InstrumentalSMN/ESP8266_RTOS_SDK/workspace/NodeMcu-V21-CP2102-Lua-ESP8266-pinout-mischianti-high-resolution.png

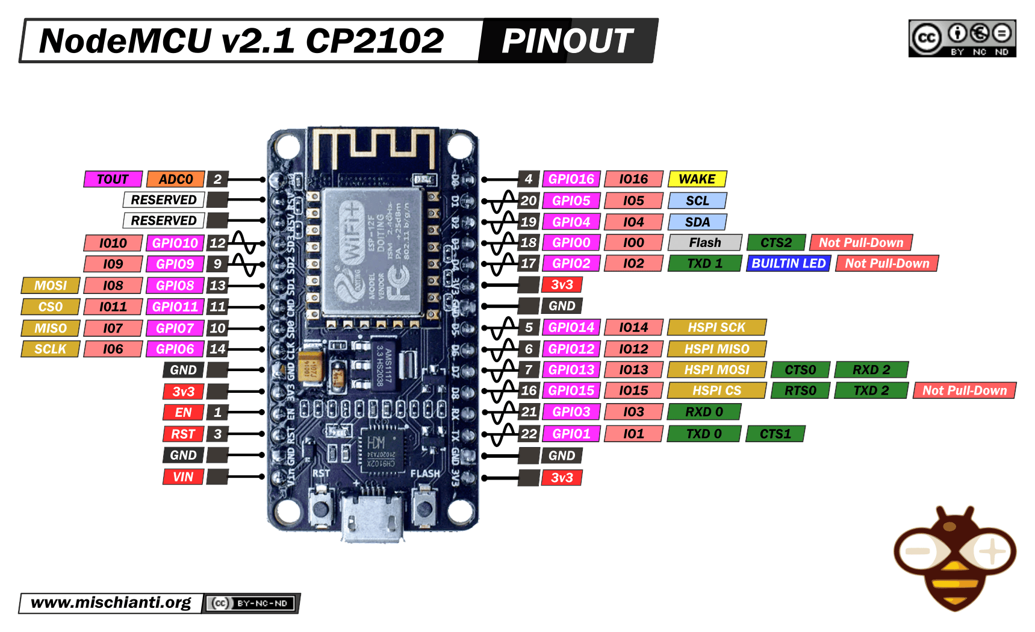
workspace/NodeMcu-V21-CP2102-Lua-ESP8266-pinout-mischianti-high-resolution.png
