InstrumentalSMN/ESP8266_RTOS_SDK/workspace/systemMonitorLab/hardware/Documentos/Planificación de Trabajo SMA_Lab.docx

Plan de trabajo

Sistema de monitoreo ambiente para el laboratorio de calibración (RIC III)

Autor: Cristian Aranda

Registro de cambios

Revisión | Cambios Realizados | Fecha
1.1 | Creación del documento | 09/06/2023
1.2
1.3

1. Descripción técnica y propósito del proyecto

La CLI cuenta con un laboratorio donde realiza calibraciones en las variables temperatura, humedad y presión. Las condiciones ambientes del laboratorio son de interés a la hora de realizar cualquier experimento, por ejemplo, para medir la presión, es preciso que la temperatura se mantenga constante y que la humedad este por debajo del 80%. El objetivo de este proyecto es diseñar una red de nodos, distribuidos en distintas posiciones del laboratorio, donde medirán las variables temperatura, humedad y presión. Cada nodo deberá medir el entorno cercano de cada equipamiento de calibración. El laboratorio cuenta con los siguientes equipos:

1. Cámara climática de temperatura y humedad. (Activa)
2. Baños térmicos para termómetros de vidrio y PT100 (Activa)
3. Bomba de presión, para barómetros aneroides (Activa)
4. Cámara barométrica de presión (En mantenimiento)

Para realizar dicho propósito se implementará un nodo con la placa NodeMCU ESP8266 que medirá la presión, temperatura y humedad ambiente de sensores a determinar. Dicho nodo realizará la transmisión de los datos dentro de la red LAN interna de la CLI, por Wifi, hacia un servidor WebSocket. Se desarrollará la aplicación Web y el servidor con el framework Django en python tal que se pueda acceder desde cualquier computadora a los datos de ambiente de cualquier nodo.

2. Alcance del proyecto

El proyecto incluye:

- El diseño de un adquisidor de datos con la capacidad de medir, procesar y transmitir los

datos.

- El diseño de una aplicación Web que permita visualizar los datos en tiempo real desde cualquier PC conectada a la Red LAN del laboratorio.

El proyecto no incluye los siguientes elementos:

- La guarda de datos en una base de datos
- La interacción con el sistema de calibración

3. Lista de materiales y supuestos del proyecto

A continuación se detalla los componentes e insumos necesarios para el proyecto.

Nombre del Producto | Proveedor/Empresa | Cantidad | Precio por unidad ( $ARS) | Total ( $ARS) | DataSheet | JUSTIFICACIÓN Y USO
Sensor de temperatura y humedad | Aht10 (https://articulo.mercadolibre.com.ar/MLA-1165029663-sensor-humedad-y-temperatura-alta-presicion-aht10-i2c-hobb-_JM) | 1 | 1621 | 1621 | dataSheet (https://server4.eca.ir/eshop/AHT10/Aosong_AHT10_en_draft_0c.pdf) | Opcion A
| Dht22 (https://www.todomicro.com.ar/arduino/225-sensor-de-humedad-y-temperatura-dht22-arduino.html) | 1 | 3268.8 | 3268.8 | dataSheet (https://www.sparkfun.com/datasheets/Sensors/Temperature/DHT22.pdf) | Opcion B
Sensor de Presion | BMP180 (https://www.hobbytronica.com.ar/MLA-916739423-modulo-sensor-presion-atmosferica-temperatura-bmp180-arduino-_JM) | 0 | 1115 | 0 | dataSheet (https://media.digikey.com/pdf/Data%20Sheets/Bosch/BMP180.pdf) | Opcion A
| BMP280 (https://www.todomicro.com.ar/arduino/350-modulo-sensor-de-presion-y-temperatura-bmp280.html) | 5 | 1007.76 | 5038.8 | dataSheet (https://www.digikey.com/en/products/detail/bosch-sensortec/BMP280/6136307) | Opcion B
Central | ESP8266 (https://www.todomicro.com.ar/arduino/223-nodemcu-wifi-esp8266.html) | 0 | 2360.54 | 0 | dataSheet (http://www.adafruit.com/datasheets/ESP8266_Specifications_English.pdf)
Fuente | PowerSupply (https://www.todomicro.com.ar/cargadores-y-baterias/666-fuente-de-alimentacion-5v-2a.html) | 0 | 2941.12 | 0 | -

Tabla de componentes para el proyecto

En la tabla anterior se detallan los sensores con su precio y proveedor y cantidad. Cabe aclarar que solo se comprará el par Opción A u Opción B.

4. Avance del proyecto

link de tareas en Click Up: https://sharing.clickup.com/30940872/l/h/xg7p8-6924/68c866c16f51e5f

Fecha 09/06/2023:

Tareas realizadas:

- Se estudió el funcionamiento de ESP8266 y su framework.
- Se buscó y evaluó tipos de sensores aptos y compatibles con el datalogger
- Se está estudiando
- Se configuró el ESP8266 para ser programado con Eclipse y el framework ESP8266 RTOS.
- Se creó un servidor TCP/IP en la red wifi de TIC y se logró la conexión del módulo ESP8266 para enviar datos de prueba al servidor

Tareas en proceso:

- Se está estudiando la programación con FREE RTOS
- Se está realizando programas de prueba para enviar mensajes al servidor de prueba NET CAT
- Se está estudiando la interfaz SPI/I2C de los sensores para conectar con el módulo ESP8266

Próximas tareas:

- Crear un servidor WEB socket con DJANGO channels.
- Comprar los sensores y realizar pruebas

4. Requerimientos

a) Requerimientos de Hardware

b) Requerimientos de Software

c) Requerimientos de medición

d) Requerimientos de comunicación

f) Requerimientos de funcionamiento

5. Entregables principales del proyecto

6. Desglose del trabajo en tareas

8. Gestión de riesgos

9. Gestión de la calidad

Av. Dorrego 4019 (C1425GBE) Buenos Aires, Argentina Tel: (+54 011) 5167-6767 - smn@smn.gob.ar

1983/2023 - 40 años de democracia |
