InstrumentalSMN/ESP8266_RTOS_SDK/workspace/systemMonitorLab/hardware/Documentos/Insumos SistemaDeMonitoreoAmbiente.xlsx

Articulo | Cantidad | Precio Unidad | Precio Total | Proveedor | Link | Observaciones
Conversor TTL-RS232 | 2 | $4317.00 | $8634.00 | CandyHo | https://candy-ho.com/producto/modulo-conector-max3232-rs232-serial-port-ttl-converter-db9/
Sensor BMP280 | 3 | $1931.00 | $5793.00 | CandyHo | https://candy-ho.com/producto/sensor-presion-atmosferica-arduino-bmp280-barometro-alta-pr/
Tiras de pines hembra Arduino | 4 | $759.00 | $3036.00 | CandyHo | https://candy-ho.com/producto/tiras-de-40-pines-hembra-paso-2-54mm-recta-1-fila-arduino/
Kit de cables Arduino | 1 | $7561.00 | $7561.00 | CandyHo | https://candy-ho.com/producto/kit-120-cables-20cm-protoboard-arduino-m-m-m-h-h-h-kit22/
Multímetro Digital | 3 | $31493.00 | $94479.00 | Electrocomponentes SA | https://www.electrocomponentes.com/tienda/instrumental-medicion/multimetros/portatiles/multimetro-digital-compacto-uni-t-ut33a-plus-tester
Conversor TTL-RS485 | 3 | $2260.00 | $6780.00 | Microelectronica | https://www.microelectronicash.com/arduino-485xttl--det--ARDUINO-485XTTL
LLAVE TECLA C/LUZ 10A 250V ON-OFF | 2 | $1087.94 | $2175.88 | Microelectronica | https://www.microelectronicash.com/lt-105--det--LT-105
FUENTE SWITCHING 5V 2.5A | 3 | $7280.27 | $21840.81 | Microelectronica | https://www.microelectronicash.com/fuente-sw5-2-5--det--FUENTE-SW5-2.5
ALICATE PUNTA FINA 1mm 130mm | 2 | $17151.75 | $34303.50 | Microelectronica | https://www.microelectronicash.com/xr-170ii--det--XR-170II (https://www.microelectronicash.com/fuente-sw5-2-5--det--FUENTE-SW5-2.5)
LUPA DE VIDRIO CON PIE Y SOPORTES | 2 | $11282.04 | $22564.08 | Microelectronica | https://www.microelectronicash.com/lupa-pie--det--LUPA-PIE (https://www.microelectronicash.com/stanley-84054--det--STANLEY-84054)
TIRA DE PINES LARGOS 2x40 P/IMPRESO | 6 | $1821.34 | $10928.04 | Microelectronica | https://www.microelectronicash.com/tpl2x40--det--TPL2X40
BORNERA DOBLE AZUL PARA IMPRESO 8A 300V | 3 | $250.61 | $751.83 | Microelectronica | https://www.microelectronicash.com/b2p--det--B2P (https://www.microelectronicash.com/xr-170ii--det--XR-170II)
BORNERA TRIPLE AZUL PARA IMPRESO 8A 300V | 3 | $290.08 | $870.24 | Microelectronica | https://www.microelectronicash.com/b3p--det--B3P (https://www.microelectronicash.com/lupa-pie--det--LUPA-PIE)
ALICATE P/ELECTRICIDAD 1000V | 2 | $15289.85 | $30579.70 | SyC | http://www.sycelectronica.com.ar/articulo.php?codigo=HT-917
MALLA DESOLDANTE 2.0MM | 2 | $1167.27 | $2334.54 | SyC | http://www.sycelectronica.com.ar/articulo.php?codigo=MALLADESOLD-2.0
Destornilladores Perilleros Largos Plano Philips Proskit 509 | 2 | $9700.00 | $19400.00 | TECNOCENTER | https://articulo.mercadolibre.com.ar/MLA-1164194081-destornilladores-perilleros-largos-plano-philips-proskit-509-_JM
Sensor DHT22 | 2 | $7434.00 | $14868.00 | TodoMicro | Sensor De Humedad Y Temperatura DHT22 (todomicro.com.ar) (https://www.todomicro.com.ar/arduino/225-sensor-de-humedad-y-temperatura-dht22-arduino.html)
NodeMCU ESP8266 | 2 | $5123.30 | $10246.60 | TodoMicro | Nodemcu Wifi Esp8266 (todomicro.com.ar) (https://www.todomicro.com.ar/arduino/223-nodemcu-wifi-esp8266.html)
 |  |  | $297146.22
 |  | Para comprar | $57211.48
SaldoClaudio | 50000
 |  |  | -$7211.48
 |  | Microelectronica | $100214.38
 |  |  | $0.00
 |  |  | $0.00
 |  |  | $0.00
TOTAL |  |  | $744506.82
Presupuesto |  |  | $18000000.00
Restante |  |  | $17255493.18
