InstrumentalSMN/ESP8266_RTOS_SDK/workspace/systemMonitorLab/hardware/3DCase/Sistema de monitoreo/Bottom Carcaza/Botton Carcaza.stl

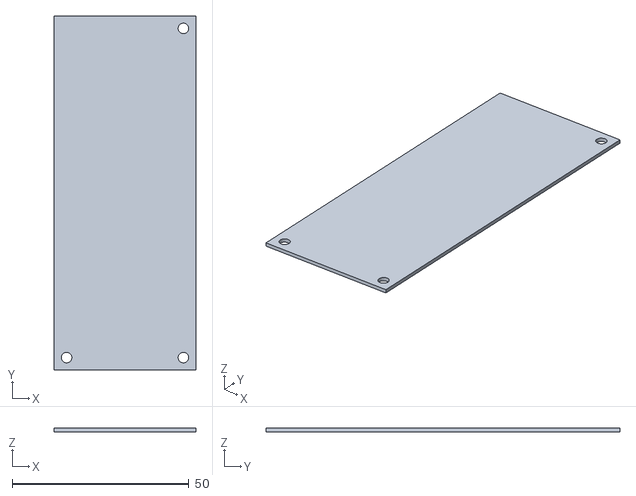
[picture p2: CAD file, 2025-02-17]
workspace/systemMonitorLab/hardware/3DCase/Sistema de monitoreo/Bottom Carcaza/Botton Carcaza.stl
40.0 x 100.0 x 1.00
