InstrumentalSMN/ESP8266_RTOS_SDK/workspace/systemMonitorLab/hardware/3DCase/Sistema de monitoreo/Top Carcaza/tinker.obj

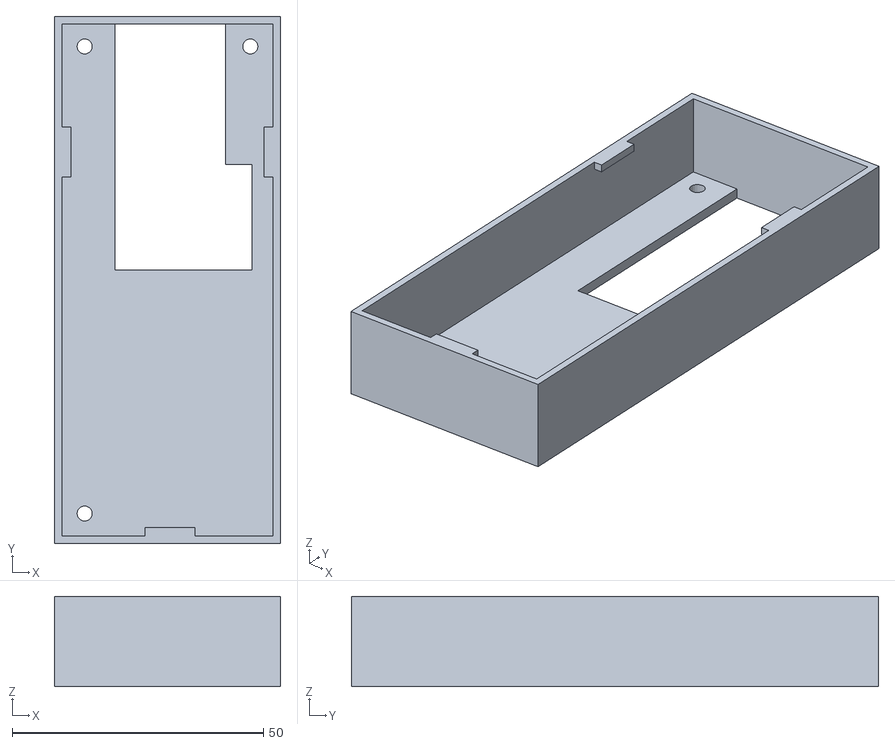
[picture p3: CAD file, 2025-02-17]
workspace/systemMonitorLab/hardware/3DCase/Sistema de monitoreo/Top Carcaza/tinker.obj
45.0 x 105.0 x 18.0
