InstrumentalSMN/ESP8266_RTOS_SDK/workspace/systemMonitorLab/hardware/NodoAmbienteSMN/recursos/bmp280_module.stp

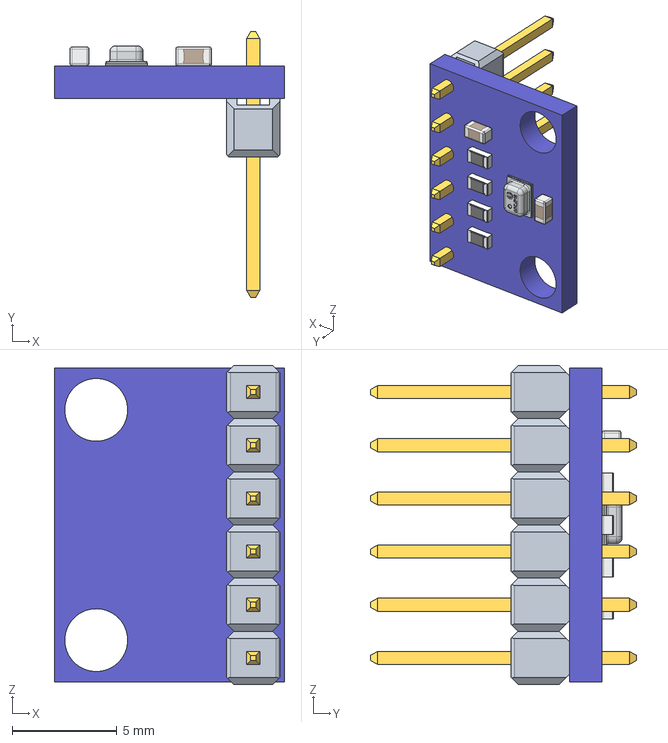
[picture p4: CAD file, 2025-02-21]
workspace/systemMonitorLab/hardware/NodoAmbienteSMN/recursos/bmp280_module.stp
11.0 x 12.7 x 15.2 mm
