InstrumentalSMN/ESP8266_RTOS_SDK/(list of files, cad)

Other CAD files:
workspace/systemMonitorLab/hardware/3DCase/Sistema de monitoreo/Bottom Carcaza/tinker.obj
workspace/systemMonitorLab/hardware/3DCase/Sistema de monitoreo/Top Carcaza/Top Carcaza.stl
workspace/systemMonitorLab/hardware/NodoAmbienteSMN/recursos/bmp280_module_Shrinkwrap.ipt
