InstrumentalSMN/ESP8266_RTOS_SDK/workspace/systemMonitorLab/hardware/NodoAmbienteSMN/NodoV2/pcb_build_resources/PCBsystem_page-0001.jpg

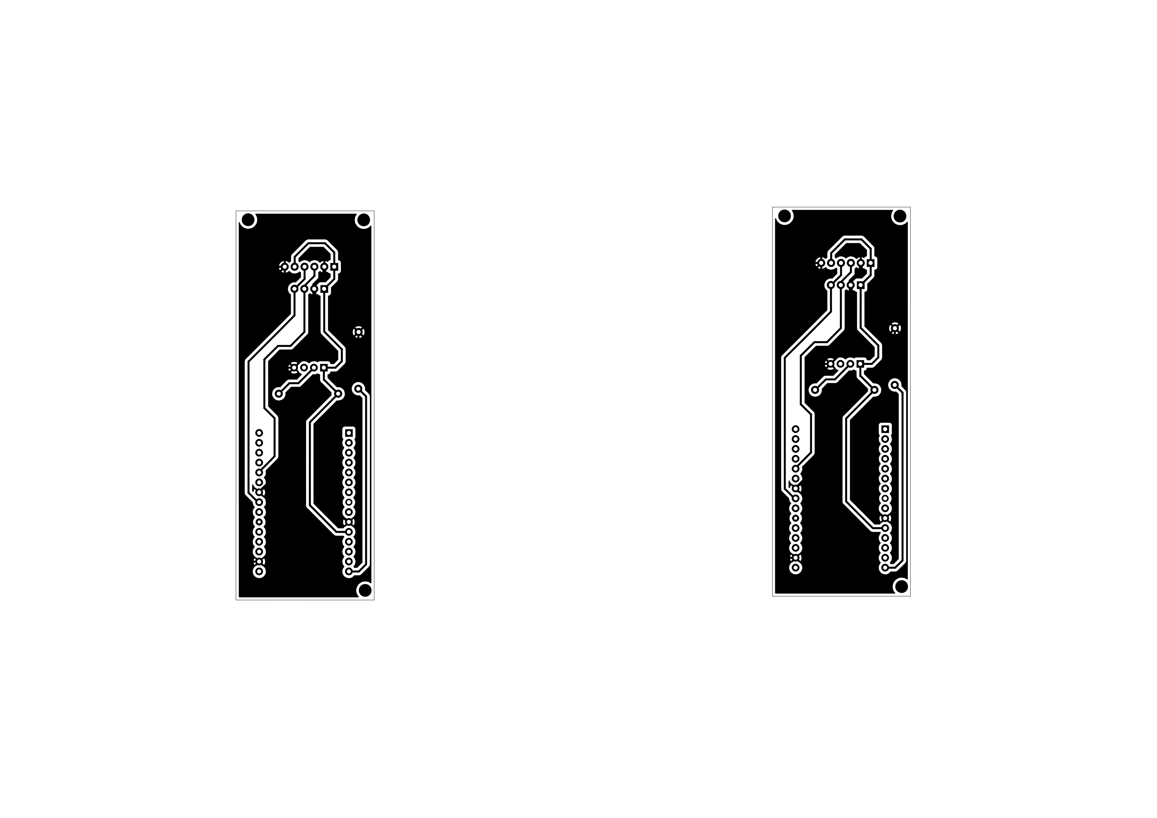
workspace/systemMonitorLab/hardware/NodoAmbienteSMN/NodoV2/pcb_build_resources/PCBsystem_page-0001.jpg
