InstrumentalSMN/ESP8266_RTOS_SDK/workspace/systemMonitorLab/hardware/Pruebas/aht10.png

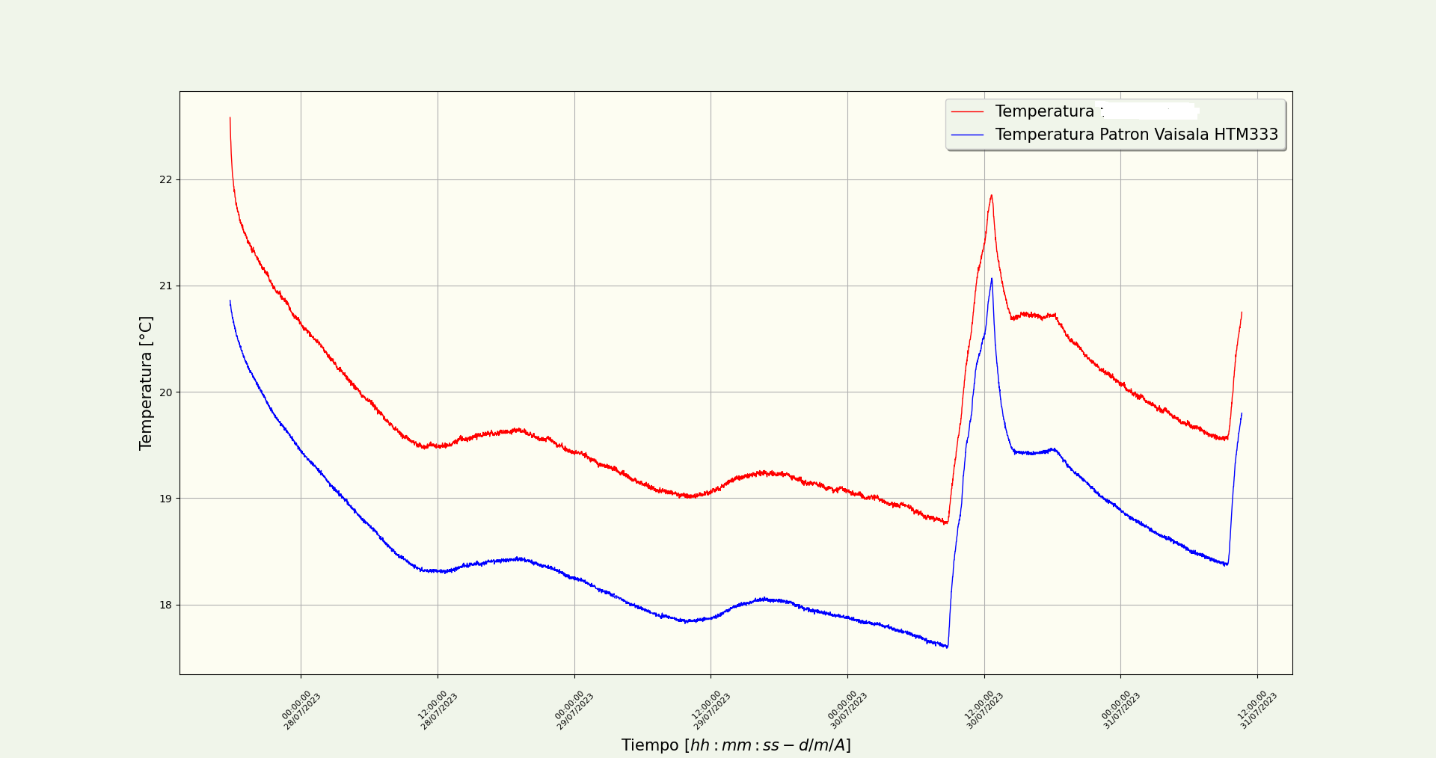
workspace/systemMonitorLab/hardware/Pruebas/aht10.png
