InstrumentalSMN/ESP8266_RTOS_SDK/workspace/systemMonitorLab/hardware/Pruebas/aht10_rh.png

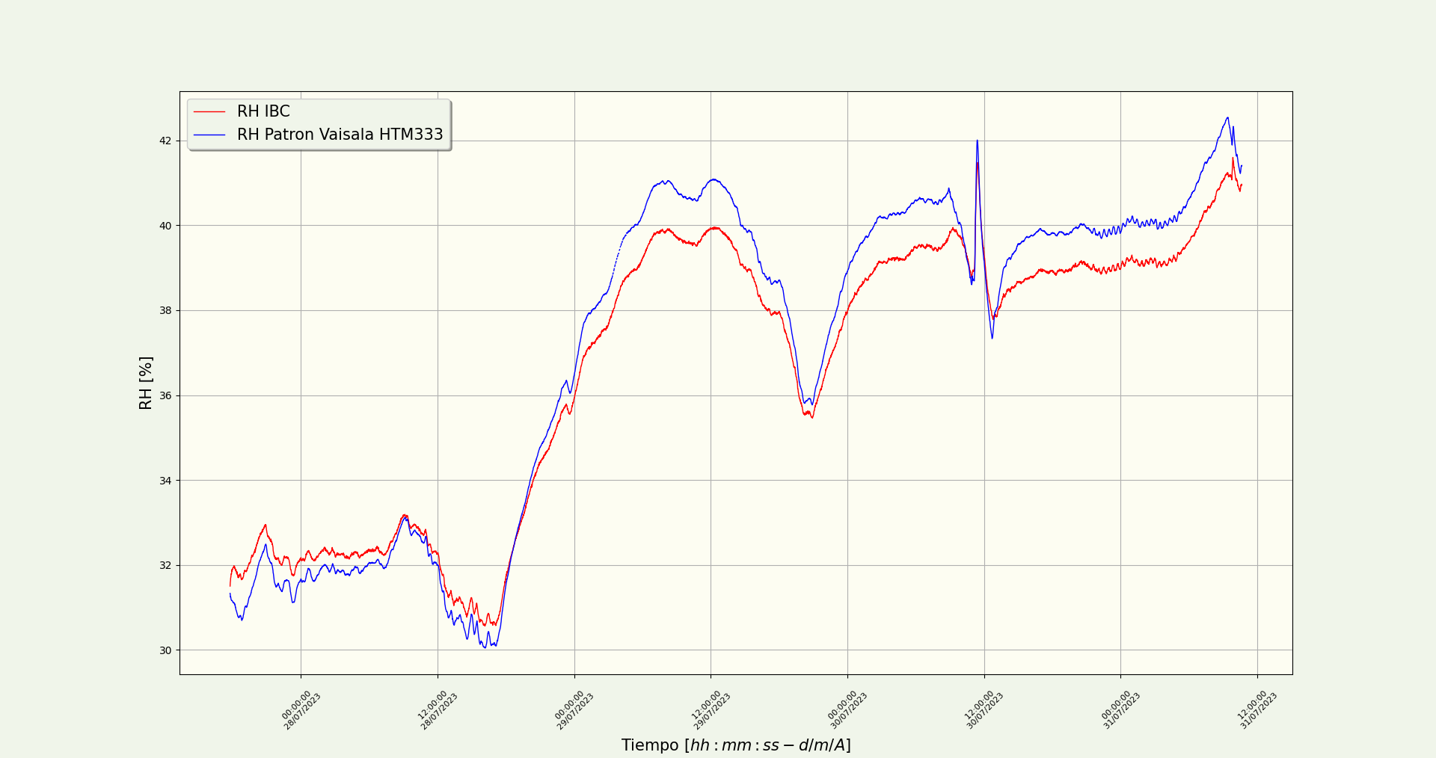
workspace/systemMonitorLab/hardware/Pruebas/aht10_rh.png
