InstrumentalSMN/ESP8266_RTOS_SDK/workspace/systemMonitorLab/hardware/Pruebas/bmp280.png

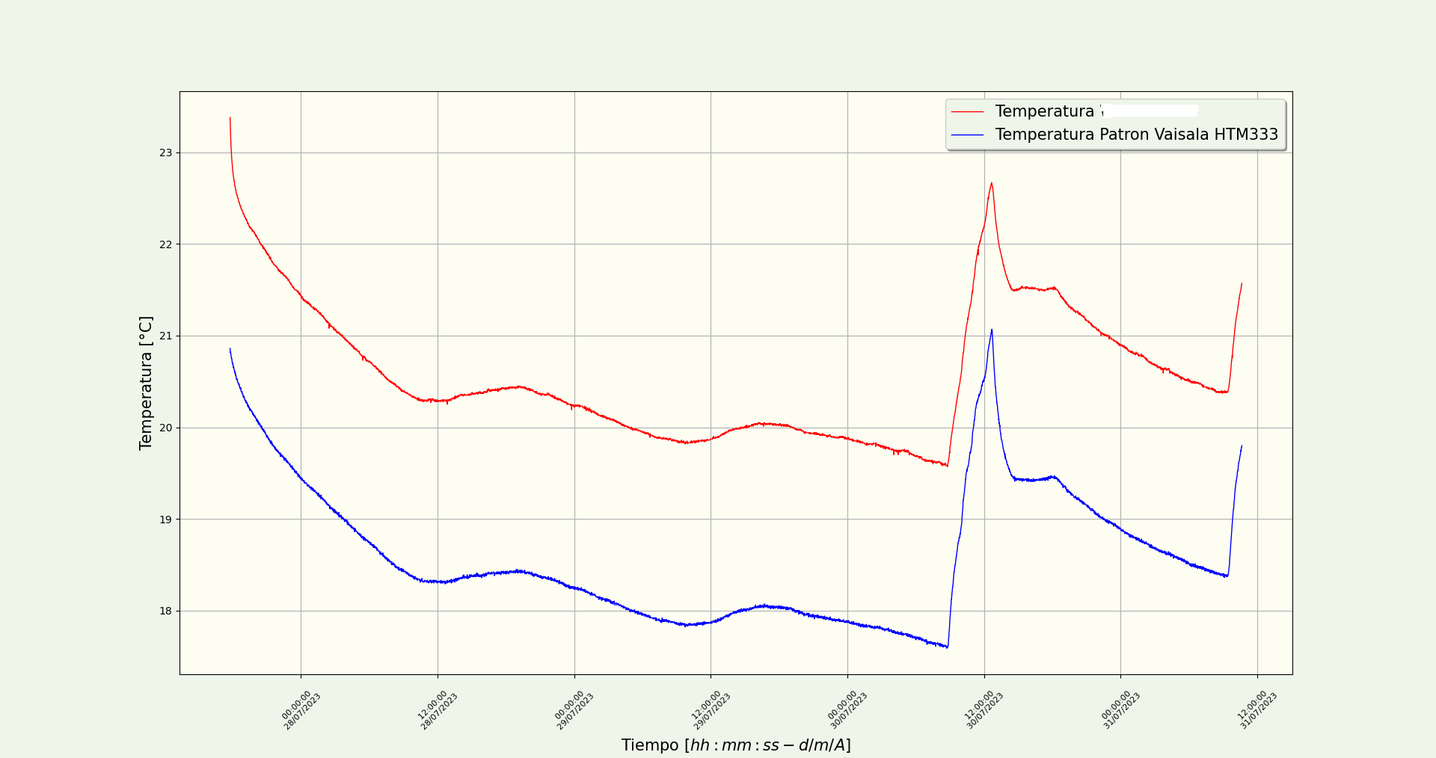
workspace/systemMonitorLab/hardware/Pruebas/bmp280.png
