InstrumentalSMN/ESP8266_RTOS_SDK/workspace/systemMonitorLab/hardware/Pruebas/DHT22_rh.png

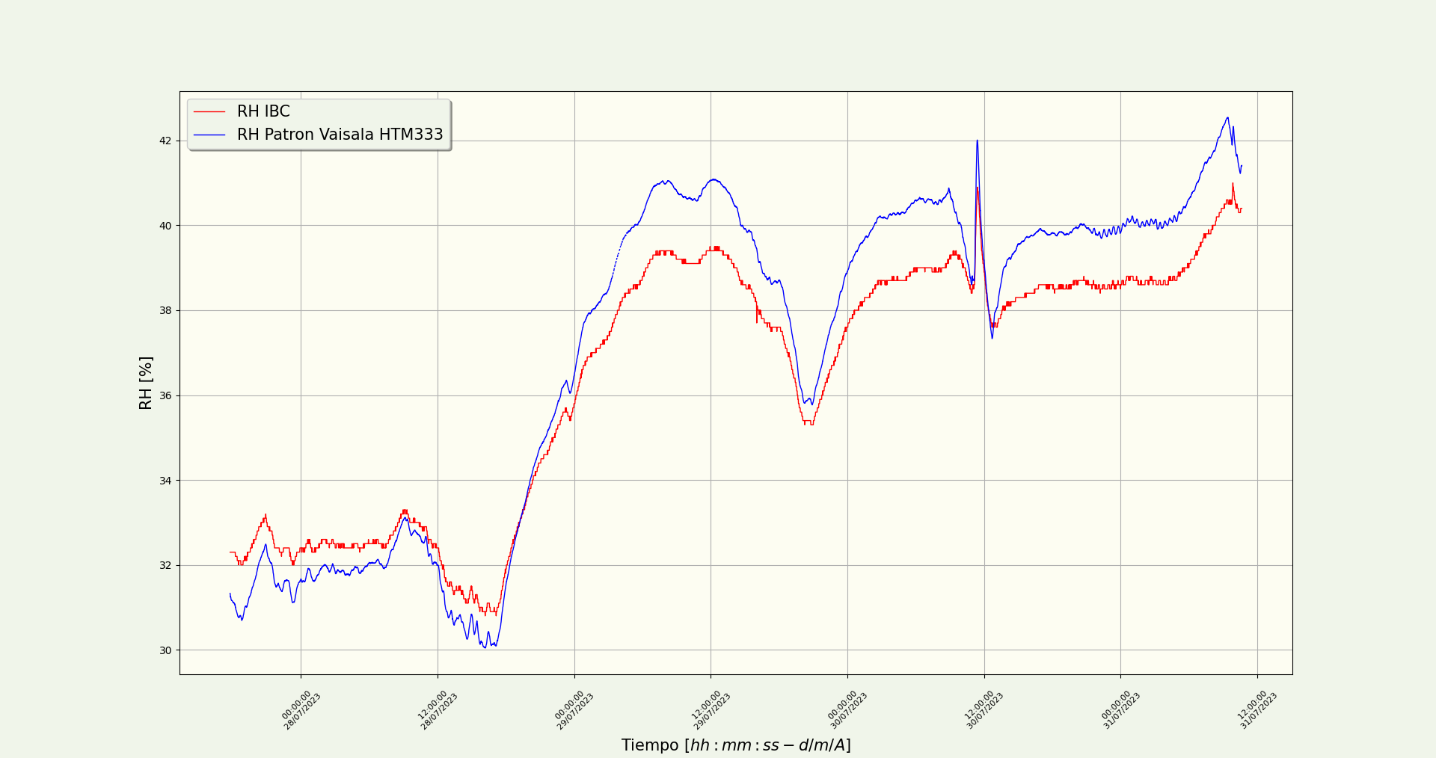
workspace/systemMonitorLab/hardware/Pruebas/DHT22_rh.png
