InstrumentalSMN/ESP8266_RTOS_SDK/workspace/systemMonitorLab/hardware/NodoAmbienteSMN/NodoV2/pcb_build_resources/PCBsystem.pdf

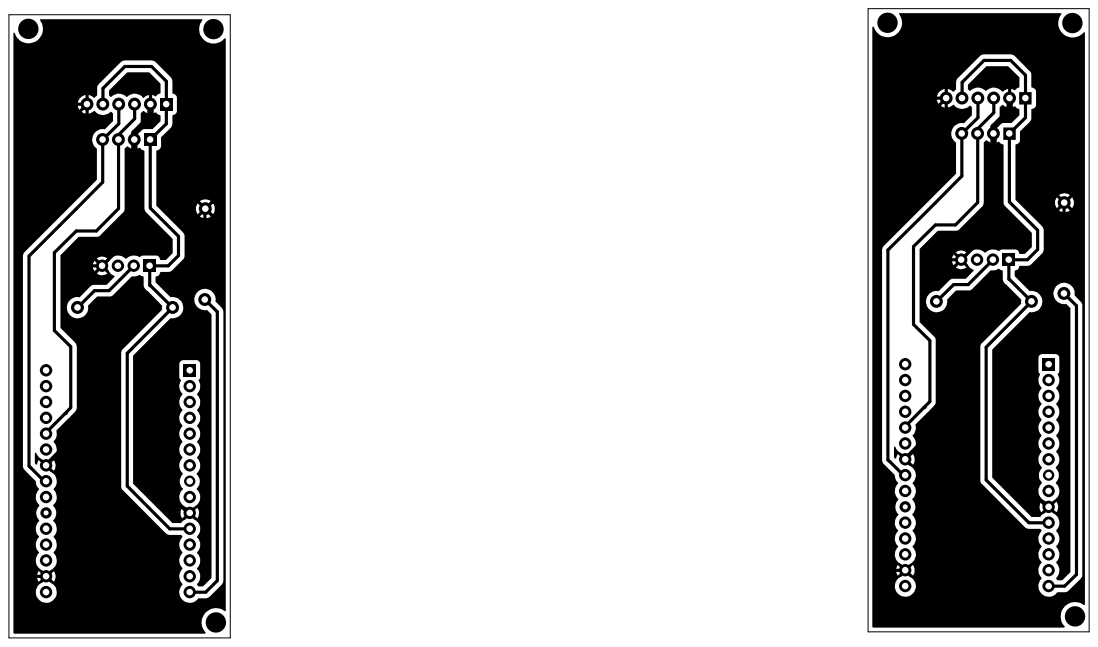
[picture p10: page 1]
