InstrumentalSMN/ESP8266_RTOS_SDK/workspace/systemMonitorLab/hardware/NodoAmbienteSMN/recursos/simulaciones/prueba.asc

Q1: npn; 2N2222
Q2: pnp; 2N2907
R1: res; 10k
R2: res; 4.7k
R3: res; 1k
R4: res; 4.7k
R5: res; 1k
V1: voltage; 0
V2: voltage; 5
Named nets: PWM_IN, PWM_OUT
