InstrumentalSMN/ESP8266_RTOS_SDK/workspace/systemMonitorLab/hardware/NodoAmbienteSMN/NodoV1/PcbSistemaAmbienteLab.kicad_pcb

## KiCad design workspace/systemMonitorLab/hardware/NodoAmbienteSMN/NodoV1/PcbSistemaAmbienteLab.kicad_pcb (2023-09-05, an earlier design)

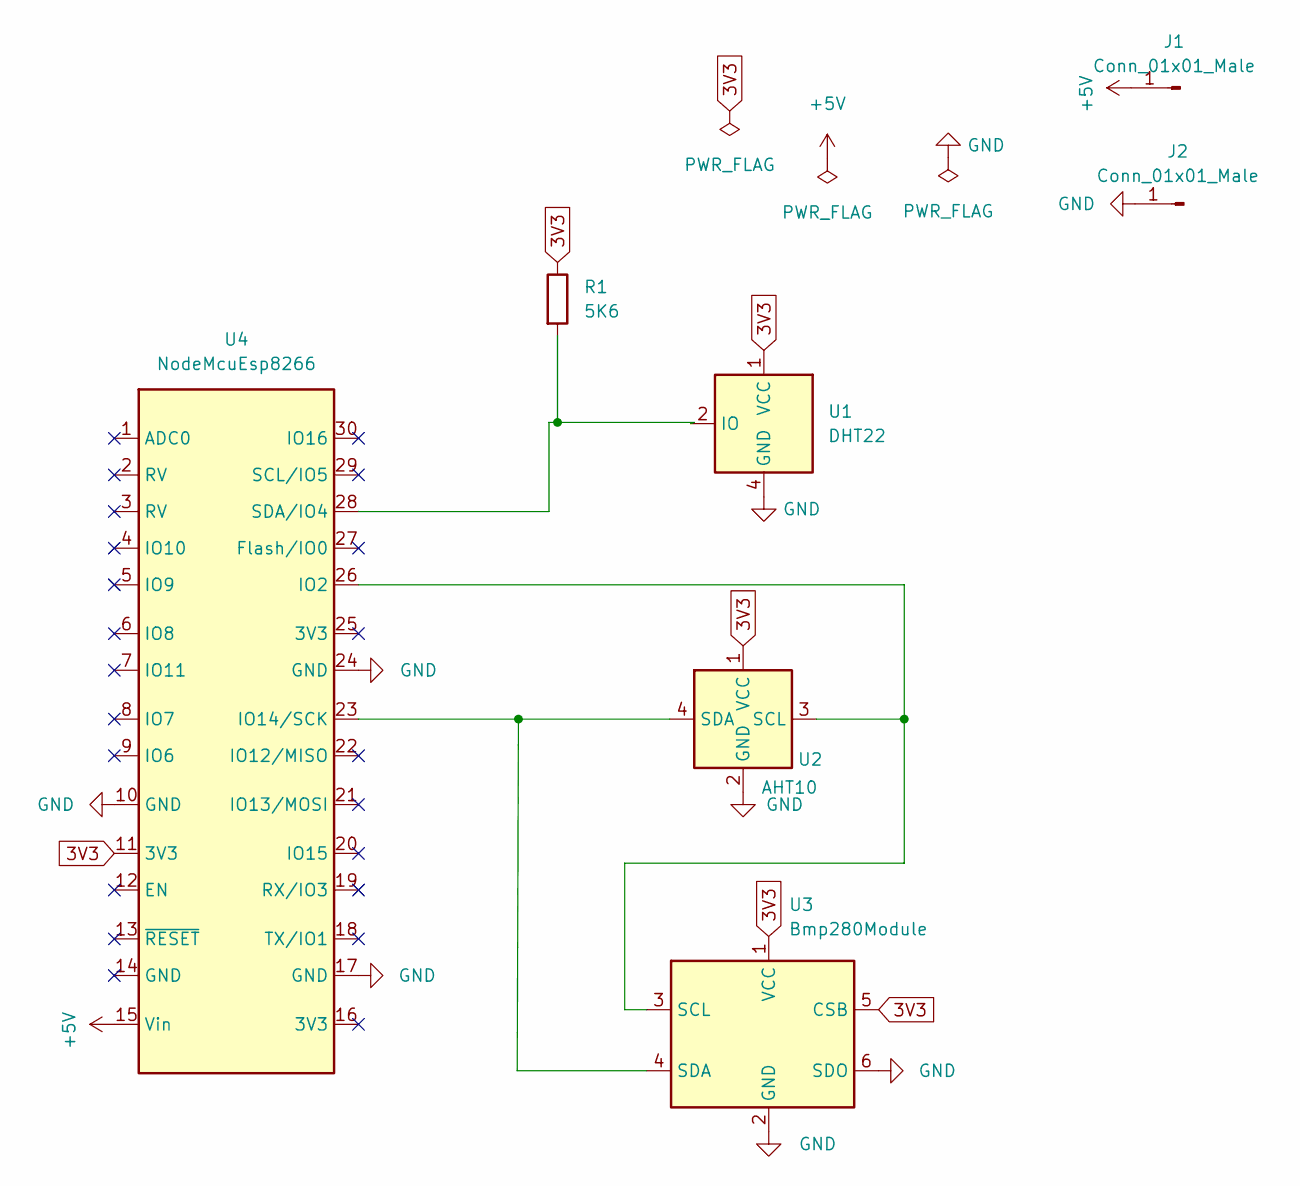
[picture p11: schematic PcbSistemaAmbienteLab.kicad_sch, Nodo de temperatura, humedad y presión]

Parts:
J1, J2: Conn_01x01_Male; Pin_D1.0mm_L10.0mm
R1: 5K6; R_Axial_DIN0207_L6.3mm_D2.5mm_P15.24mm_Horizontal
U1: DHT22; Aosong_DHT11_5.5x12.0_P2.54mm
U2: AHT10; PinHeader_1x04_P2.54mm_Vertical
U3: Bmp280Module; PinHeader_1x06_P2.54mm_Vertical
U4: NodeMcuEsp8266; ESP8266

Connections:
3V3: R1.1, U1.1 (VCC), U2.1 (VCC), U3.1 (VCC), U3.5 (CSB), U4.11 (3V3)
+5V: J1.1, U4.15 (Vin)
GND: J2.1, U1.4 (GND), U2.2 (GND), U3.2 (GND), U3.6 (SDO), U4.10 (GND), U4.17 (GND), U4.24 (GND)
unnamed: R1.2, U1.2 (IO), U4.28 (SDA/IO4)
unnamed: U2.3 (SCL), U3.3 (SCL), U4.26 (IO2)
unnamed: U2.4 (SDA), U3.4 (SDA), U4.23 (IO14/SCK)

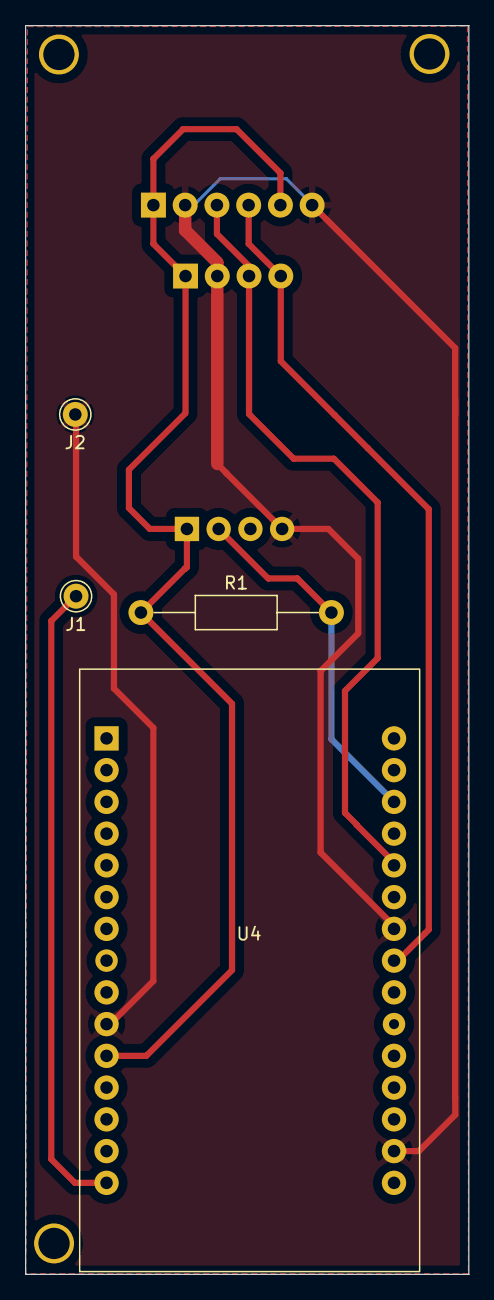
[picture p12: board PcbSistemaAmbienteLab.kicad_pcb from above]

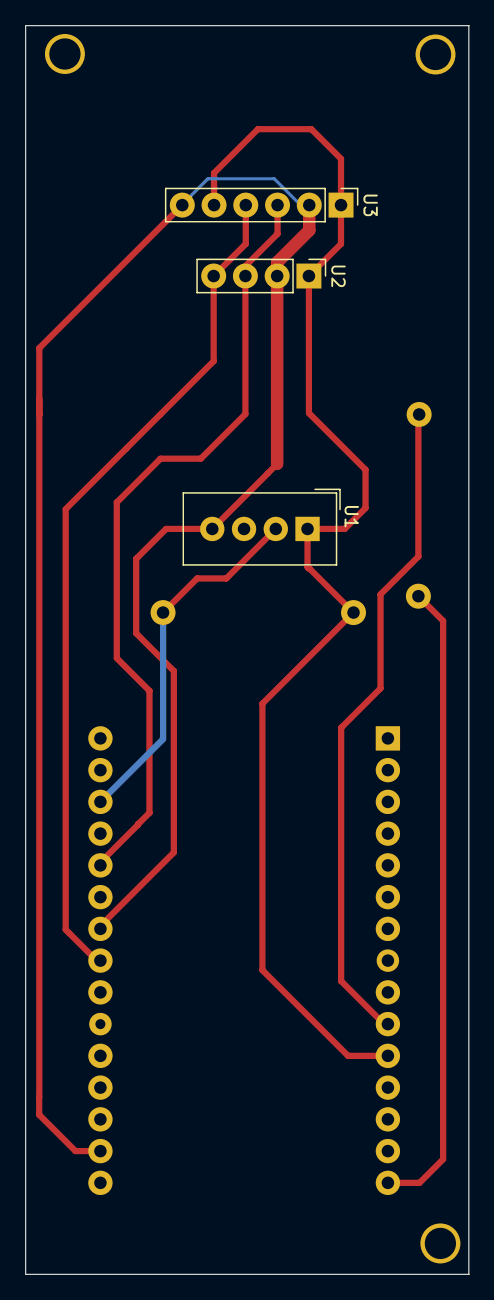
[picture p13: board PcbSistemaAmbienteLab.kicad_pcb from below]

Board: 2 copper layers, 35.5 x 99.9 mm, 7 parts (3 on the bottom side), 6 nets.
