InstrumentalSMN/ESP8266_RTOS_SDK/workspace/systemMonitorLab/hardware/NodoAmbienteSMN/NodoV2/PcbSistemaAmbienteLab_shield_sensors.kicad_pcb

## KiCad design workspace/systemMonitorLab/hardware/NodoAmbienteSMN/NodoV2/PcbSistemaAmbienteLab_shield_sensors.kicad_pcb (2025-02-21)

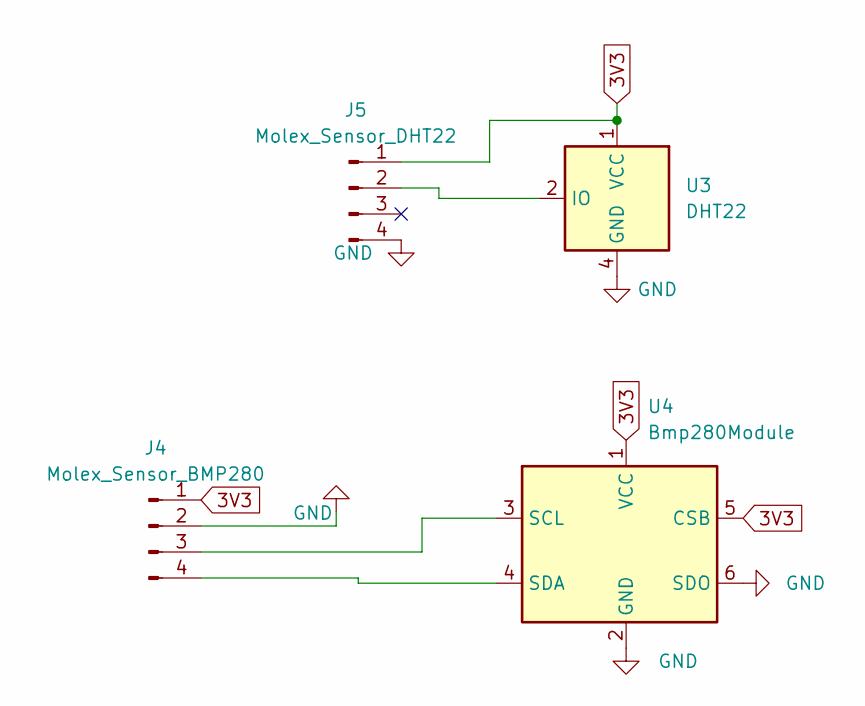
[picture p14: schematic shield_sensor.kicad_sch]

Parts:
J4: Molex_Sensor_BMP280; PinHeader_1x04_P2.54mm_Horizontal
J5: Molex_Sensor_DHT22; PinHeader_1x04_P2.54mm_Horizontal
U3: DHT22; Aosong_DHT11_5.5x12.0_P2.54mm
U4: Bmp280Module; BMP280_Module

Connections:
3V3: J4.1, J5.1, U3.1 (VCC), U4.1 (VCC), U4.5 (CSB)
GND: J4.2, J5.4, U3.4 (GND), U4.2 (GND), U4.6 (SDO)
unnamed: J4.3, U4.3 (SCL)
unnamed: J4.4, U4.4 (SDA)
unnamed: J5.2, U3.2 (IO)

Board: 2 copper layers, 4 parts (0 on the bottom side), 5 nets, no tracks yet.
