InstrumentalSMN/ESP8266_RTOS_SDK/workspace/systemMonitorLab/hardware/NodoAmbienteSMN/NodoV2/PcbSistemaAmbienteLab_shield_base.kicad_pcb

## KiCad design workspace/systemMonitorLab/hardware/NodoAmbienteSMN/NodoV2/PcbSistemaAmbienteLab_shield_base.kicad_pcb (2025-02-21)

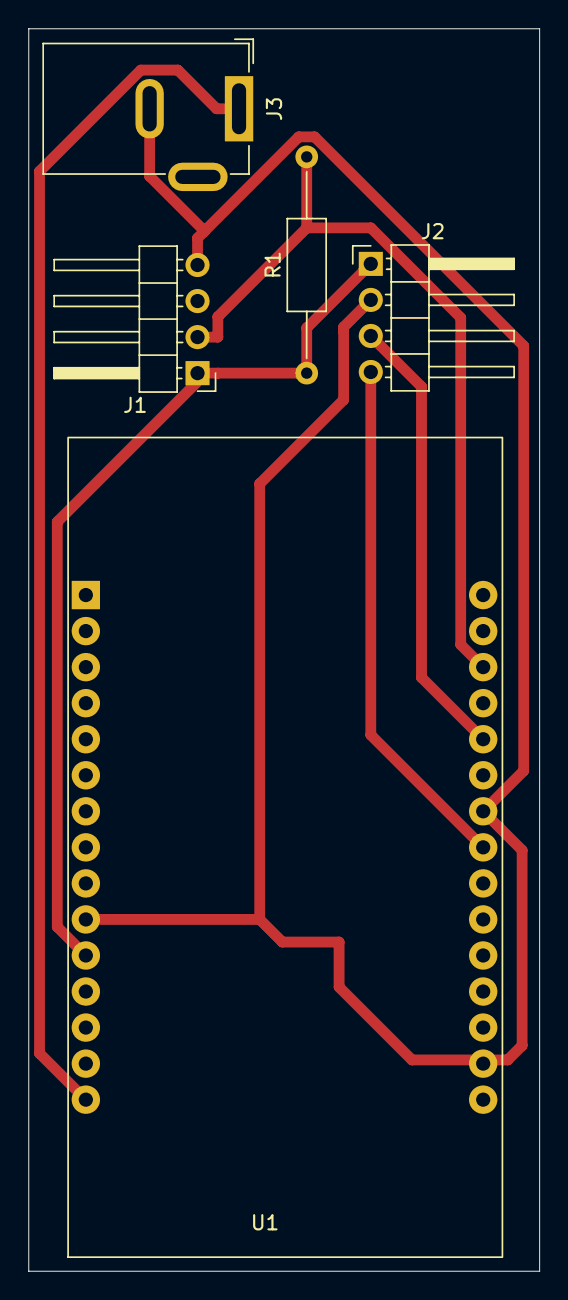
[picture p15: board PcbSistemaAmbienteLab_shield_base.kicad_pcb from above]

Board: 2 copper layers, 36.0 x 87.6 mm, 5 parts (0 on the bottom side), 6 nets.

Parts:
J1: Molex_MainBoard_DHT22; PinHeader_1x04_P2.54mm_Horizontal
J2: Molex_MainBoard_BMP280; PinHeader_1x04_P2.54mm_Horizontal
J3: Jack-DC; BarrelJack_GCT_DCJ200-10-A_Horizontal
R1: 5K6; R_Axial_DIN0207_L6.3mm_D2.5mm_P15.24mm_Horizontal
U1: NodeMcuEsp8266; ESP8266_v3

Connections:
3V3: J1.1, J2.1, R1.1, U1.11 (3V3)
+5V: J3.1, U1.15 (Vin)
/shield_base/SCL: J2.3, U1.26 (IO2)
/shield_base/SDA: J2.4, U1.23 (IO14/SCK)
GND: J1.4, J2.2, J3.2, U1.10 (GND), U1.17 (GND), U1.24 (GND)
unnamed: J1.2, R1.2, U1.28 (SDA/IO4)
