InstrumentalSMN/ESP8266_RTOS_SDK/workspace/systemMonitorLab/hardware/NodoAmbienteSMN/NodoV2/PcbSistemaAmbienteLab_shield_base_2.kicad_pcb

## KiCad design workspace/systemMonitorLab/hardware/NodoAmbienteSMN/NodoV2/PcbSistemaAmbienteLab_shield_base_2.kicad_pcb (2025-02-21)

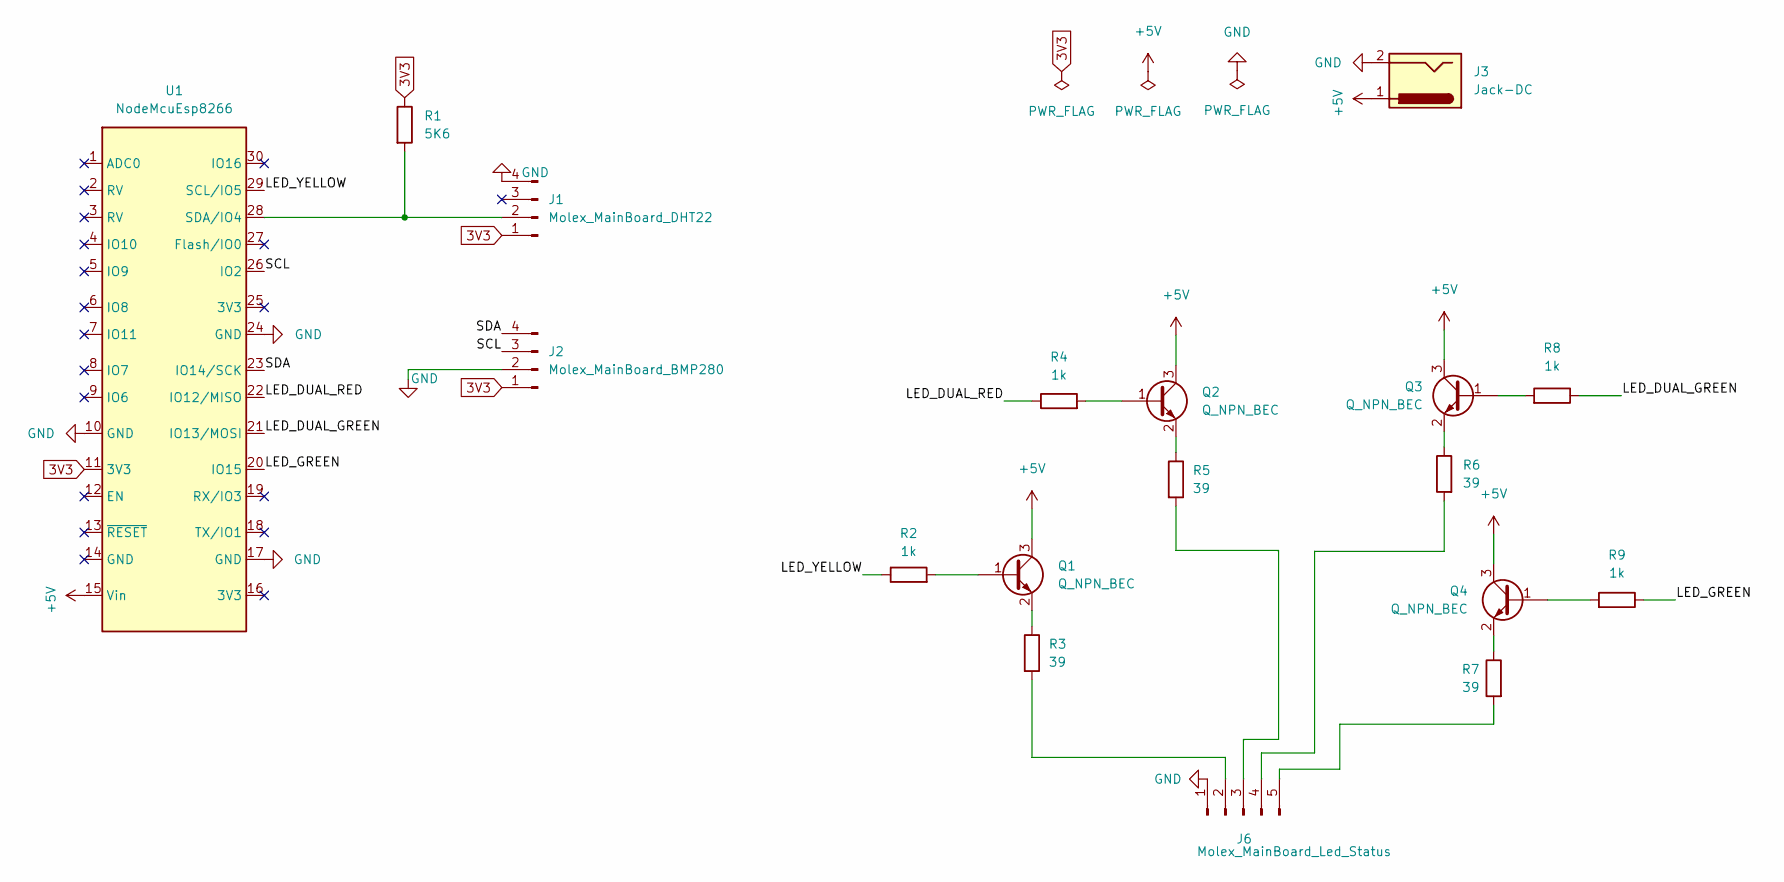
[picture p16: schematic shield_base.kicad_sch, shield_base_nodo_lab_smn]

Parts:
J1: Molex_MainBoard_DHT22; PinHeader_1x04_P2.54mm_Horizontal
J2: Molex_MainBoard_BMP280; PinHeader_1x04_P2.54mm_Horizontal
J3: Jack-DC; BarrelJack_GCT_DCJ200-10-A_Horizontal
J6: Molex_MainBoard_Led_Status; PinHeader_1x05_P2.54mm_Horizontal
Q1, Q2, Q3, Q4: Q_NPN_BEC; SOT-23
R1: 5K6; R_1206_3216Metric
R2, R4, R8, R9: 1k; R_1206_3216Metric
R3, R5, R6, R7: 39; R_1206_3216Metric
U1: NodeMcuEsp8266; ESP8266_v3

Connections:
3V3: J1.1, J2.1, R1.1, U1.11 (3V3)
+5V: J3.1, Q1.3 (C), Q2.3 (C), Q3.3 (C), Q4.3 (C), U1.15 (Vin)
/shield_base/LED_DUAL_GREEN: R8.1, U1.21 (IO13/MOSI)
/shield_base/LED_DUAL_RED: R4.1, U1.22 (IO12/MISO)
/shield_base/LED_GREEN: R9.1, U1.20 (IO15)
/shield_base/LED_YELLOW: R2.1, U1.29 (SCL/IO5)
/shield_base/SCL: J2.3, U1.26 (IO2)
/shield_base/SDA: J2.4, U1.23 (IO14/SCK)
GND: J1.4, J2.2, J3.2, J6.1, U1.10 (GND), U1.17 (GND), U1.24 (GND)
unnamed: J1.2, R1.2, U1.28 (SDA/IO4)
unnamed: J6.2, R3.2
unnamed: J6.3, R5.2
unnamed: J6.4, R6.2
unnamed: J6.5, R7.2
unnamed: Q1.1 (B), R2.2
unnamed: Q1.2 (E), R3.1
unnamed: Q2.1 (B), R4.2
unnamed: Q2.2 (E), R5.1
unnamed: Q3.1 (B), R8.2
unnamed: Q3.2 (E), R6.1
unnamed: Q4.1 (B), R9.2
unnamed: Q4.2 (E), R7.1

Board: 2 copper layers, 18 parts (13 on the bottom side), 22 nets, no tracks yet.
