InstrumentalSMN/ESP8266_RTOS_SDK/(commit log)

2023-06-12 Inicio de proyecto en workspace
2023-07-05 Se sube los archvios .c y .h para leer y mostrar los datos del sensor AHT10
2023-07-07 Version 1.0 de firmware para enviar datos de los termohigrometros a un servidor crudo TCP/IP local cada 10 segundos
2023-07-21 Se agrego los sensores AHT10 y BMP280 por i2c y DHT22 por protocolo propio, trasminte a un sever local
2023-07-31 Subo el desarrollo de PCB para el ESP8266 con los sensores y perifericos necesarios
    [PcbSistemaAmbienteLab.kicad_pcb, PcbSistemaAmbienteLab.kicad_sch]
2023-08-02 Esquemativo v1.0 y PCB v1.0
    [PcbSistemaAmbienteLab.kicad_pcb, PcbSistemaAmbienteLab.kicad_sch]
2023-08-03 Esquematico y PCB para sistema de monitoreo v1.1
    [PcbSistemaAmbienteLab.kicad_pcb, PcbSistemaAmbienteLab.kicad_sch]
2023-08-14 subo v1.2 del PCB del sistema de monitoreo ambiente, esta versión se utilizara para calibrar el sensor AHT10 vs DHT22
    [PcbSistemaAmbienteLab.kicad_pcb, PcbSistemaAmbienteLab.kicad_sch]
2023-09-05 Dejo transmitiendo cada 1 minuto
    [PcbSistemaAmbienteLab.kicad_pcb]
2023-10-03 Se agregar las correcciones para cada sensor a partir de la calibración de temperatura y humedad y para presino se agrega 1 hPa dando buenos resultados de comparación frente a un patrón
2025-01-15 Se agrega la conexion con un servidor WebSocket y sus correspondientes codificadores de mensajes de 125 y 126
2025-02-10 Se agrego la primer version del firmware v1.0, que envia las mediciones de temp, rh y presión con un intervalo de tiempo configurable
2025-02-17 Subimo la version 2 de la PCB de nodo ambiente.
    [Botton Carcaza.stl, Insumos SistemaDeMonitoreoAmbiente.xlsx, PcbSistemaAmbienteLab.kicad_pcb, PcbSistemaAmbienteLab.kicad_sch, Top Carcaza.stl, shield_base.kicad_sch, shield_sensor.kicad_sch, tinker.obj]
2025-02-21 Se agregan leds de estado con sus respectivos conectores y se agrega en el codigo la configuracion de los GPIO para usar estos leds como indicadores de envio de datos, conexion con el servidor Web So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
    [PcbSistemaAmbienteLab.kicad_sch, PcbSistemaAmbienteLab_shield_base.kicad_pcb, PcbSistemaAmbienteLab_shield_base_2.kicad_pcb, PcbSistemaAmbienteLab_shield_sensors.kicad_pcb, bmp280_module.stp, bmp280_module_Shrinkwrap.ipt, shield_base.kicad_sch, shield_leds_status.kicad_sch]
2025-02-24 Se agrego una simulacion para manejar un pwm
